oyeniyihakeem08-blip/ECM-Synchronika-Custom-Control-Board/README.md

 Project Description

This specification defines a custom control PCB to replace the factory GICAR control board and PID controller in an ECM Synchronika dual-boiler espresso machine. The design must be:

- **Plug & Play**: Direct replacement using existing machine wiring
- **Reversible**: Original equipment can be reinstalled without modification
- **Universal Voltage**: Support 100-240V AC, 50/60Hz worldwide operation
- **Production Ready**: Suitable for small-batch or volume manufacturing
