oyeniyihakeem08-blip/ECM-Synchronika-Custom-Control-Board/3D MODELS/9 pos terminal block.stp

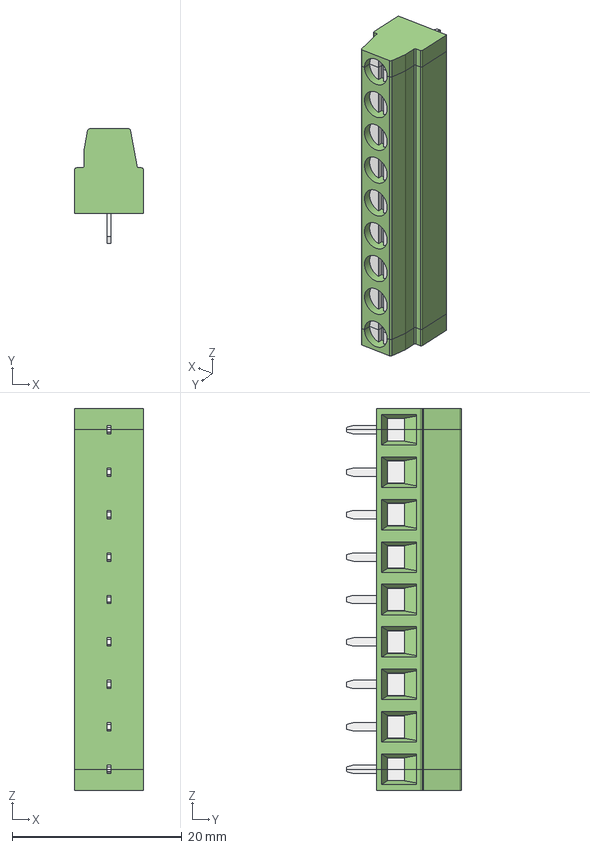
[picture p1: CAD file, 2025-12-05]
3D MODELS/9 pos terminal block.stp
8.10 x 13.5 x 45.0 mm
CIA5_DX
CIA5_SX
CIA5_CNT
