oyeniyihakeem08-blip/ECM-Synchronika-Custom-Control-Board/3D MODELS/7 pos terminal block.stp

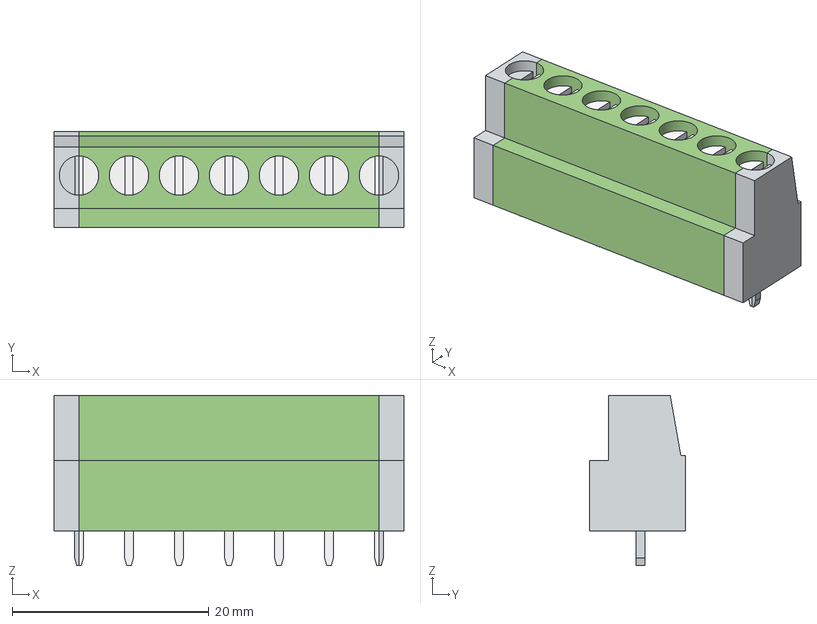
[picture p2: CAD file, 2025-12-05]
3D MODELS/7 pos terminal block.stp
35.6 x 9.80 x 17.3 mm
CLA5_08_SX_PRT.PRT
CLA5_08_DX_PRT.PRT
CLA5_08_CNT_PRT.PRT
