oyeniyihakeem08-blip/ECM-Synchronika-Custom-Control-Board/3D MODELS/5 PIN HEADER HORIZONTAL MTSW-105-24-G-S-155-RA.stp

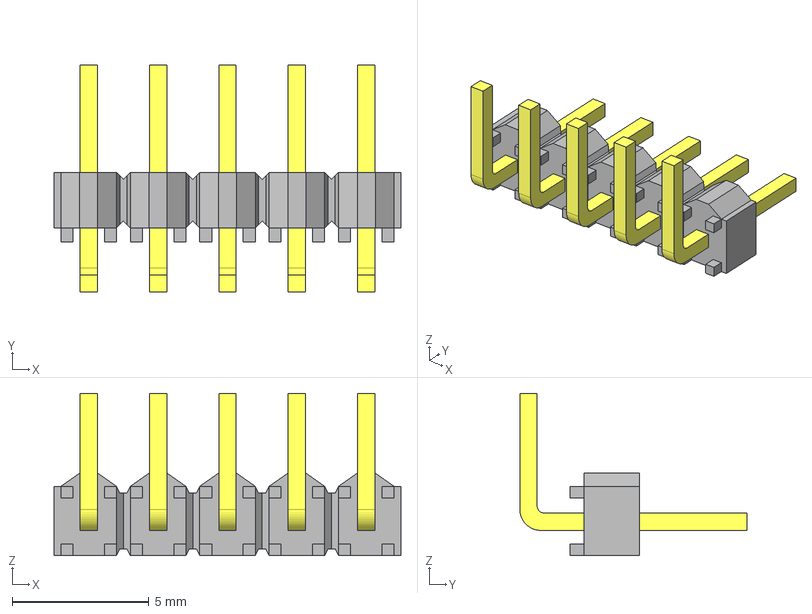
[picture p3: CAD file, 2025-12-03]
3D MODELS/5 PIN HEADER HORIZONTAL MTSW-105-24-G-S-155-RA.stp
12.7 x 8.32 x 5.94 mm
MTSW-105-24-G-S-155-RA_body
MTSW-105-24-S-155-RA
