oyeniyihakeem08-blip/ECM-Synchronika-Custom-Control-Board/3D MODELS/4 PIN HEADER HORIZONTAL MTSW-104-08-G-S-229-RA.stp

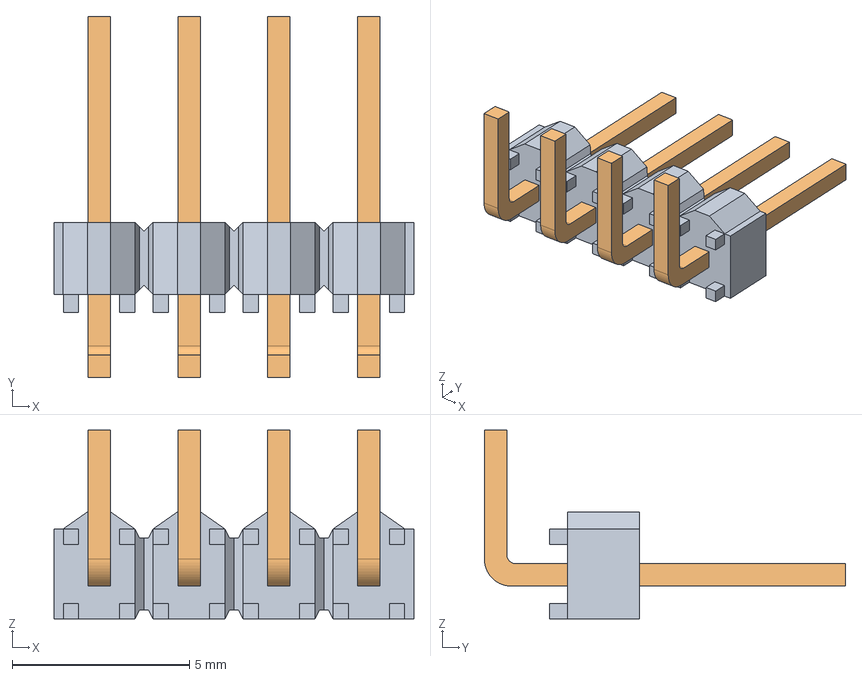
[picture p4: CAD file, 2025-12-03]
3D MODELS/4 PIN HEADER HORIZONTAL MTSW-104-08-G-S-229-RA.stp
10.2 x 10.2 x 5.33 mm
MTSW-104-08-G-S-229-RA_body
MTSW-104-08-S-229-RA
