oyeniyihakeem08-blip/ECM-Synchronika-Custom-Control-Board/3D MODELS/RELAY- G2RL_1.step

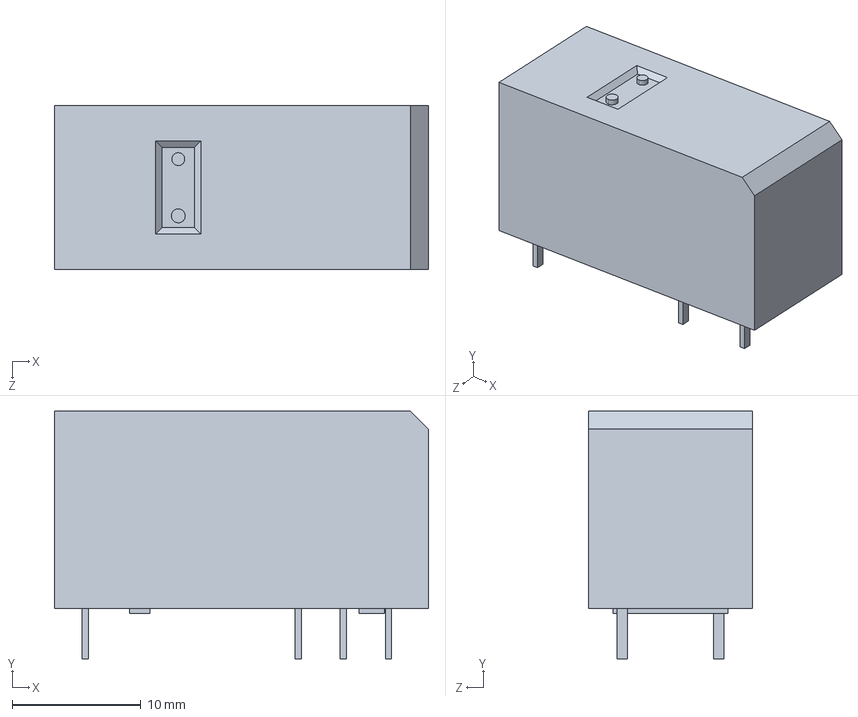
[picture p5: CAD file, 2025-12-02]
3D MODELS/RELAY- G2RL_1.step
29.0 x 19.2 x 12.7 mm
