oyeniyihakeem08-blip/ECM-Synchronika-Custom-Control-Board/3D MODELS/5_pin header  TSW-105-05-L-S-LL.stp

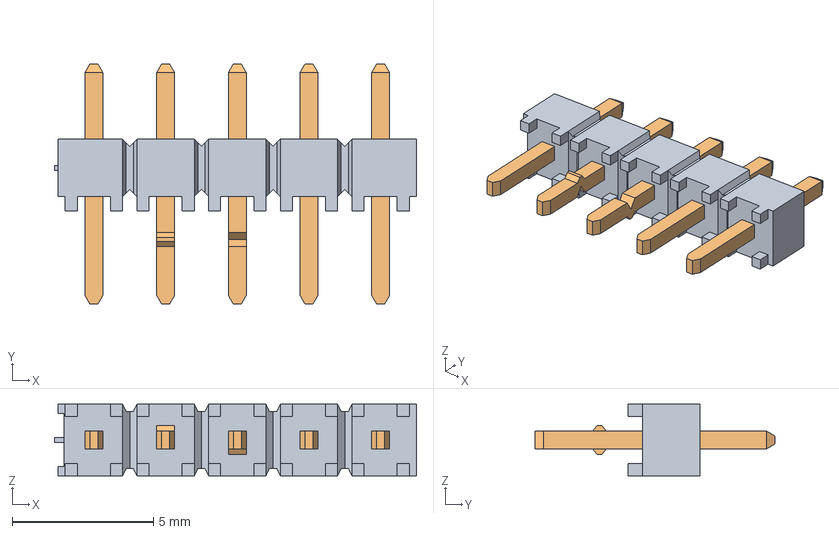
[picture p6: CAD file, 2025-11-30]
3D MODELS/5_pin header TSW-105-05-L-S-LL.stp
12.8 x 8.51 x 2.54 mm
TSW-105-05-L-S-LL_body
T-1S6-21-TSW-1-05-5-S-LL
