oyeniyihakeem08-blip/ECM-Synchronika-Custom-Control-Board/3D MODELS/4-PIN   MTLW-104-06-G-S-135.stp

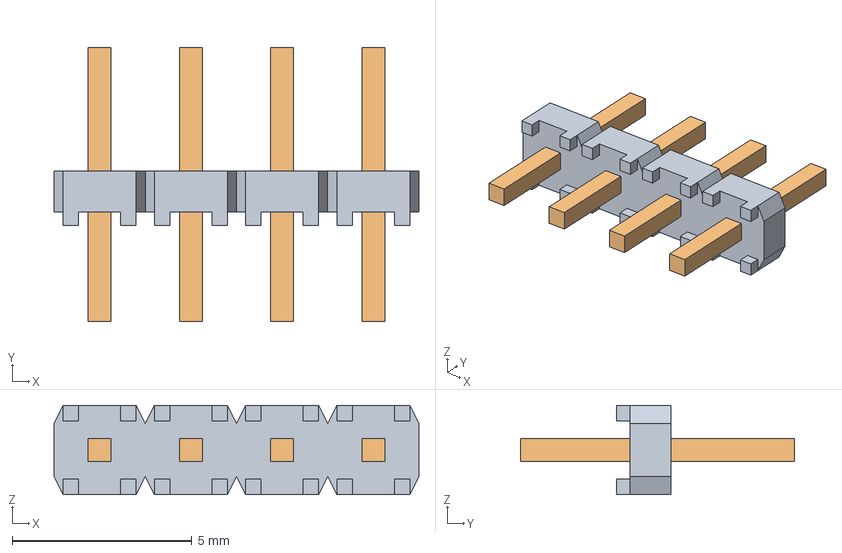
[picture p7: CAD file, 2025-11-30]
3D MODELS/4-PIN MTLW-104-06-G-S-135.stp
10.2 x 7.62 x 2.49 mm
MTLW-104-06-G-S-135_body
MTLW-04-06-S-135
