oyeniyihakeem08-blip/ECM-Synchronika-Custom-Control-Board/3D MODELS/COMPARATOR-TLV3201AIDBVR.step

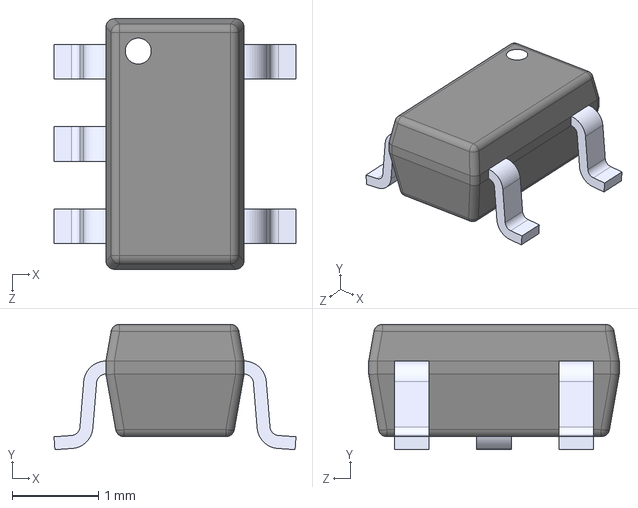
[picture p8: CAD file, 2025-11-30]
3D MODELS/COMPARATOR-TLV3201AIDBVR.step
2.80 x 1.45 x 2.90 mm
