oyeniyihakeem08-blip/ECM-Synchronika-Custom-Control-Board/3D MODELS/8_PIN_  BM08B-GHS-TBT_LF__SN__N_.step

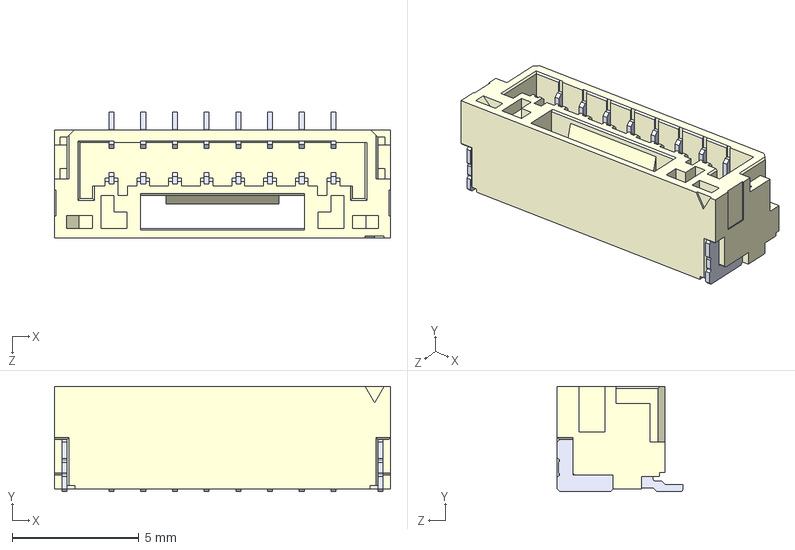
[picture p9: CAD file, 2025-11-30]
3D MODELS/8_PIN_ BM08B-GHS-TBT_LF__SN__N_.step
13.2 x 4.15 x 4.95 mm
