oyeniyihakeem08-blip/ECM-Synchronika-Custom-Control-Board/3D MODELS/6.3mm spade   928814-1.step

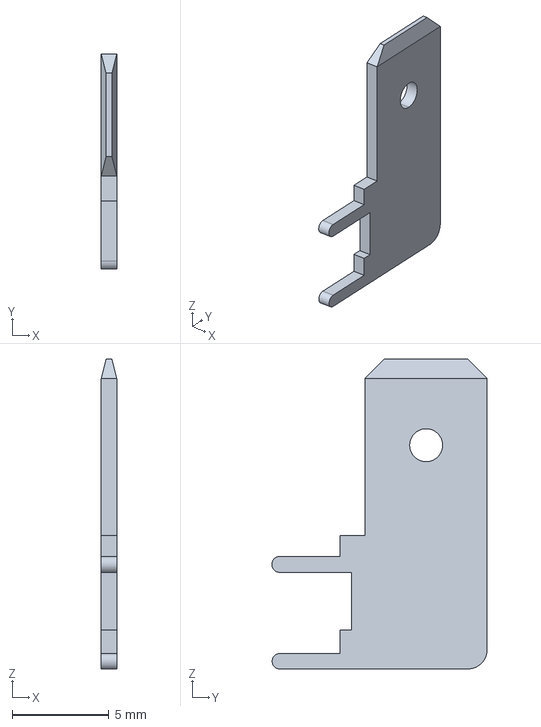
[picture p10: CAD file, 2025-11-29]
3D MODELS/6.3mm spade 928814-1.step
0.8 x 11.1 x 16.0 mm
