oyeniyihakeem08-blip/ECM-Synchronika-Custom-Control-Board/3D MODELS/HLK-5M05.step

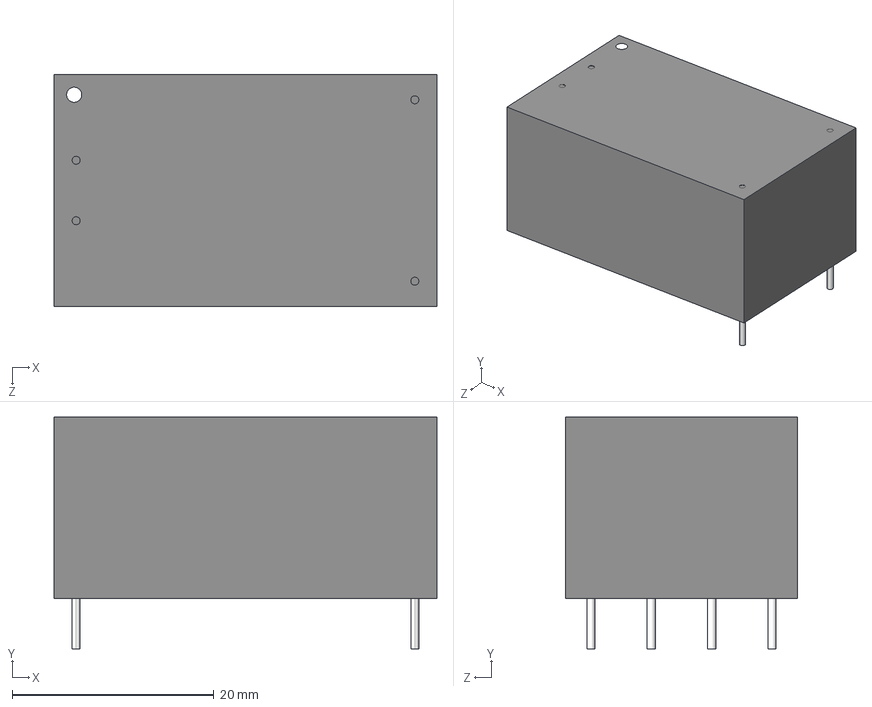
[picture p11: CAD file, 2025-11-29]
3D MODELS/HLK-5M05.step
38.0 x 23.0 x 23.0 mm
