oyeniyihakeem08-blip/ECM-Synchronika-Custom-Control-Board/3D MODELS/SMD SWITCH  EVQ-P7A01P.step

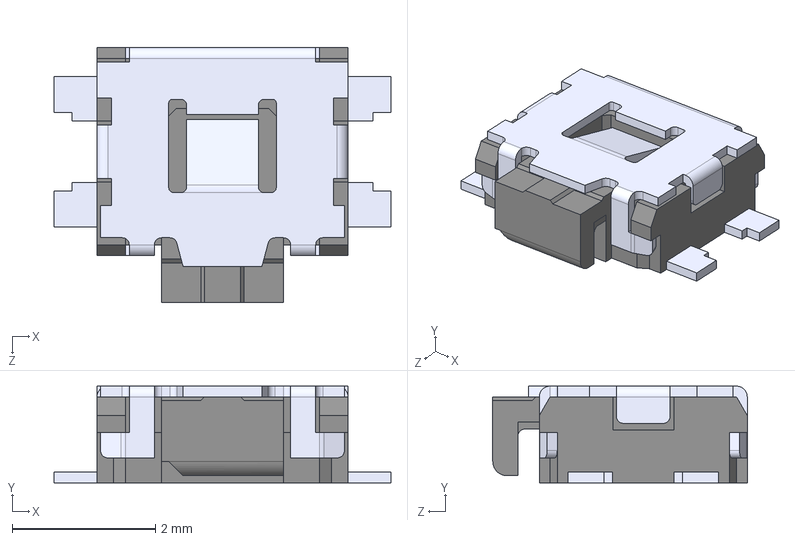
[picture p12: CAD file, 2025-11-29]
3D MODELS/SMD SWITCH EVQ-P7A01P.step
4.70 x 1.35 x 3.55 mm
