oyeniyihakeem08-blip/ECM-Synchronika-Custom-Control-Board/3D MODELS/PICO SC0915.step

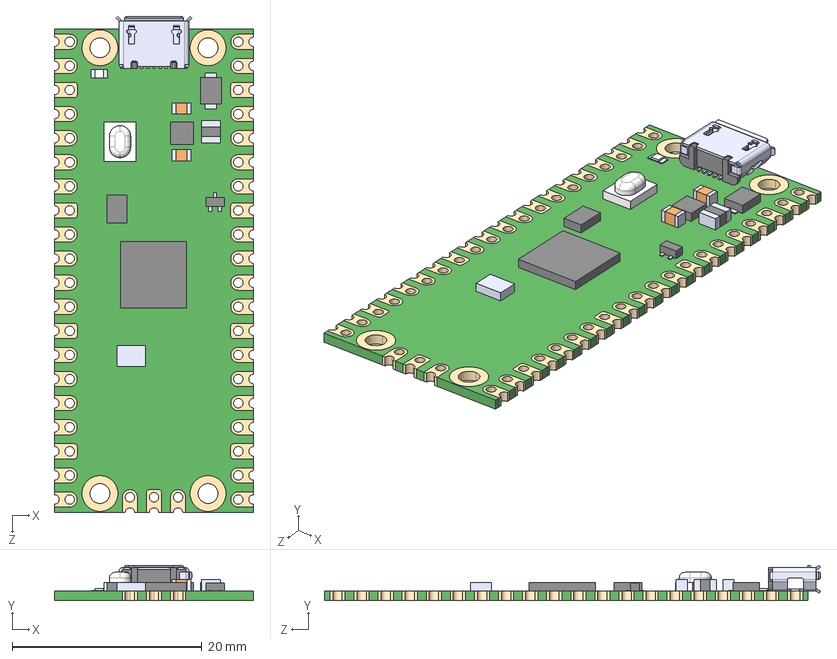
[picture p13: CAD file, 2025-11-29]
3D MODELS/PICO SC0915.step
21.0 x 3.73 x 52.3 mm
