oyeniyihakeem08-blip/ECM-Synchronika-Custom-Control-Board/3D MODELS/SPDT  40.61.9.012.0000.stp

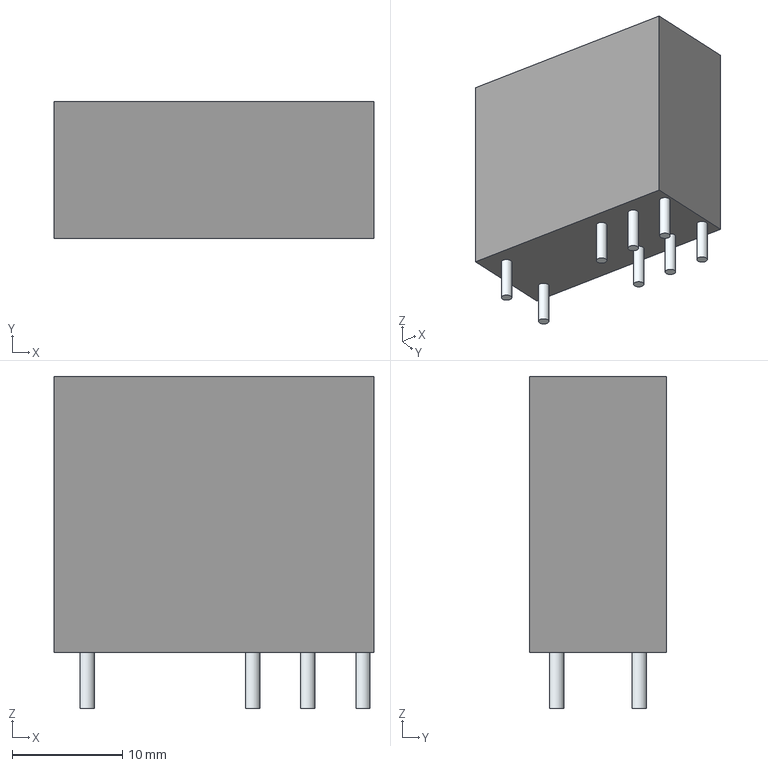
[picture p14: CAD file, 2025-11-29]
3D MODELS/SPDT 40.61.9.012.0000.stp
29.0 x 12.4 x 30.1 mm
Leads x 8
