oyeniyihakeem08-blip/ECM-Synchronika-Custom-Control-Board/ECM Synchronika Custom Control Board.kicad_pcb

## KiCad design ECM Synchronika Custom Control Board.kicad_pcb (2025-12-05)

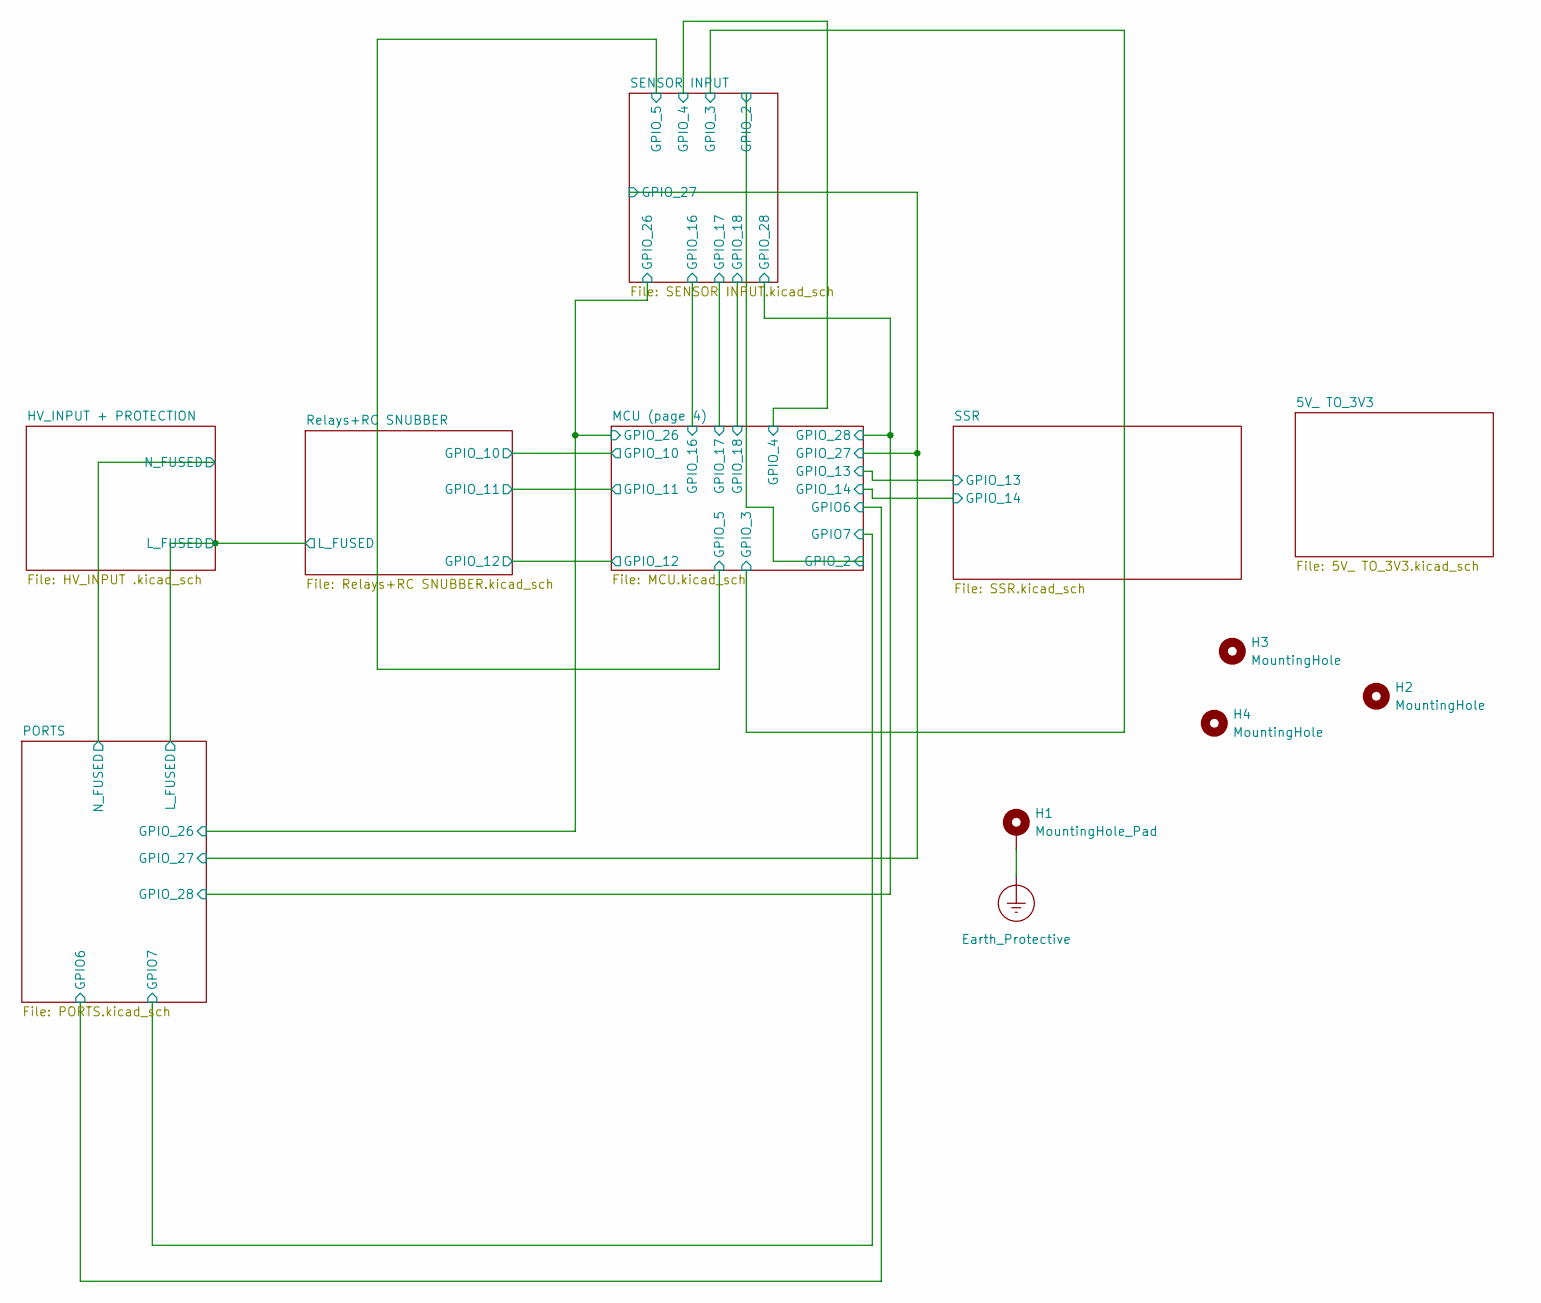
[picture p15: schematic ECM Synchronika Custom Control Board.kicad_sch]

Parts:
H1: MountingHole_Pad; MountingHole_3.2mm_M3_ISO7380_Pad_TopBottom
H2, H3, H4: MountingHole; MountingHole_3.2mm_M3_ISO14580

Connections:
Earth_Protective: H1.1; also elsewhere on the board

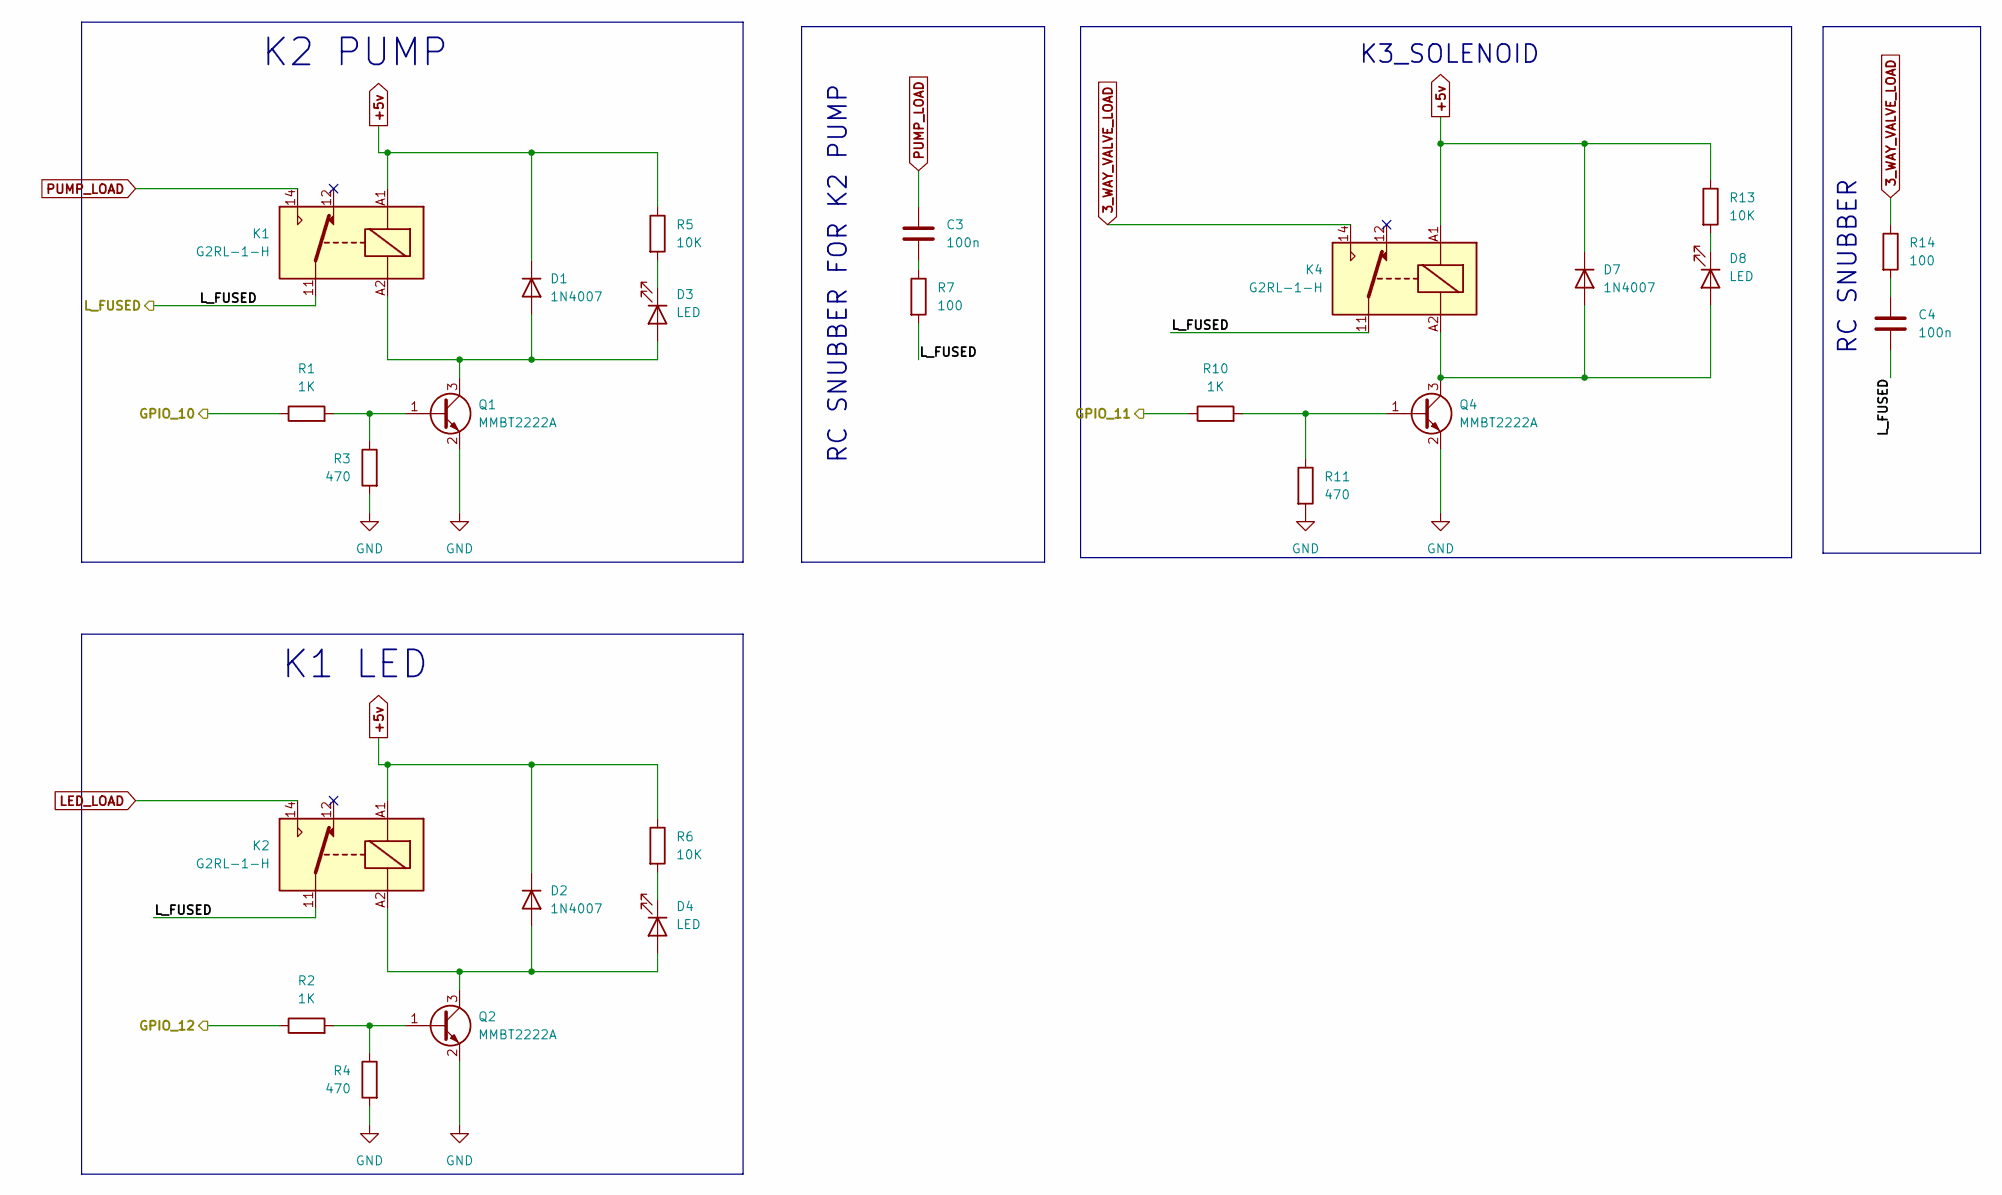
[picture p16: schematic Relays+RC SNUBBER.kicad_sch]

Parts:
C3, C4: 100n; C_Rect_L26.5mm_W11.5mm_P22.50mm_MKS4
D1, D2, D7: 1N4007; D_SMA
D3, D4, D8: LED; LED_0805_2012Metric
K1, K2, K4: G2RL-1-H; Relay_SPDT_Omron_G2RL-1 MODIFIED
Q1, Q2, Q4: MMBT2222A; SOT-23
R1, R2, R10: 1K; R_0805_2012Metric
R3, R4, R11: 470; R_0805_2012Metric
R5, R6, R13: 10K; R_0805_2012Metric
R7, R14: 100; R_1210_3225Metric

Connections:
3_WAY_VALVE_LOAD: K4.14, R14.1; also elsewhere on the board
+5v: D1.1 (K), D2.1 (K), D7.1 (K), K1.A1, K2.A1, K4.A1, R5.1, R6.1, R13.1; also elsewhere on the board
/HV_INPUT + PROTECTION/L_FUSED: C4.2, K1.11, K2.11, K4.11, R7.2; also elsewhere on the board
/MCU (page 4)/GPIO_10: R1.1; also elsewhere on the board
/MCU (page 4)/GPIO_11: R10.1; also elsewhere on the board
/MCU (page 4)/GPIO_12: R2.1; also elsewhere on the board
GND: Q1.2 (E), Q2.2 (E), Q4.2 (E), R3.2, R4.2, R11.2; also elsewhere on the board
LED_LOAD: K2.14; also elsewhere on the board
unnamed: C3.2, R7.1
unnamed: C4.1, R14.2
unnamed: D1.2 (A), D3.2 (A), K1.A2, Q1.3 (C)
unnamed: D2.2 (A), D4.2 (A), K2.A2, Q2.3 (C)
unnamed: D3.1 (K), R5.2
unnamed: D4.1 (K), R6.2
unnamed: D7.2 (A), D8.2 (A), K4.A2, Q4.3 (C)
unnamed: D8.1 (K), R13.2
unnamed: Q1.1 (B), R1.2, R3.1
unnamed: Q2.1 (B), R2.2, R4.1
unnamed: Q4.1 (B), R10.2, R11.1
PUMP_LOAD: C3.1, K1.14; also elsewhere on the board

Notes on the sheet:
K1 LED
RC SNUBBER
K2 PUMP
RC SNUBBER FOR K2 PUMP
K3_SOLENOID

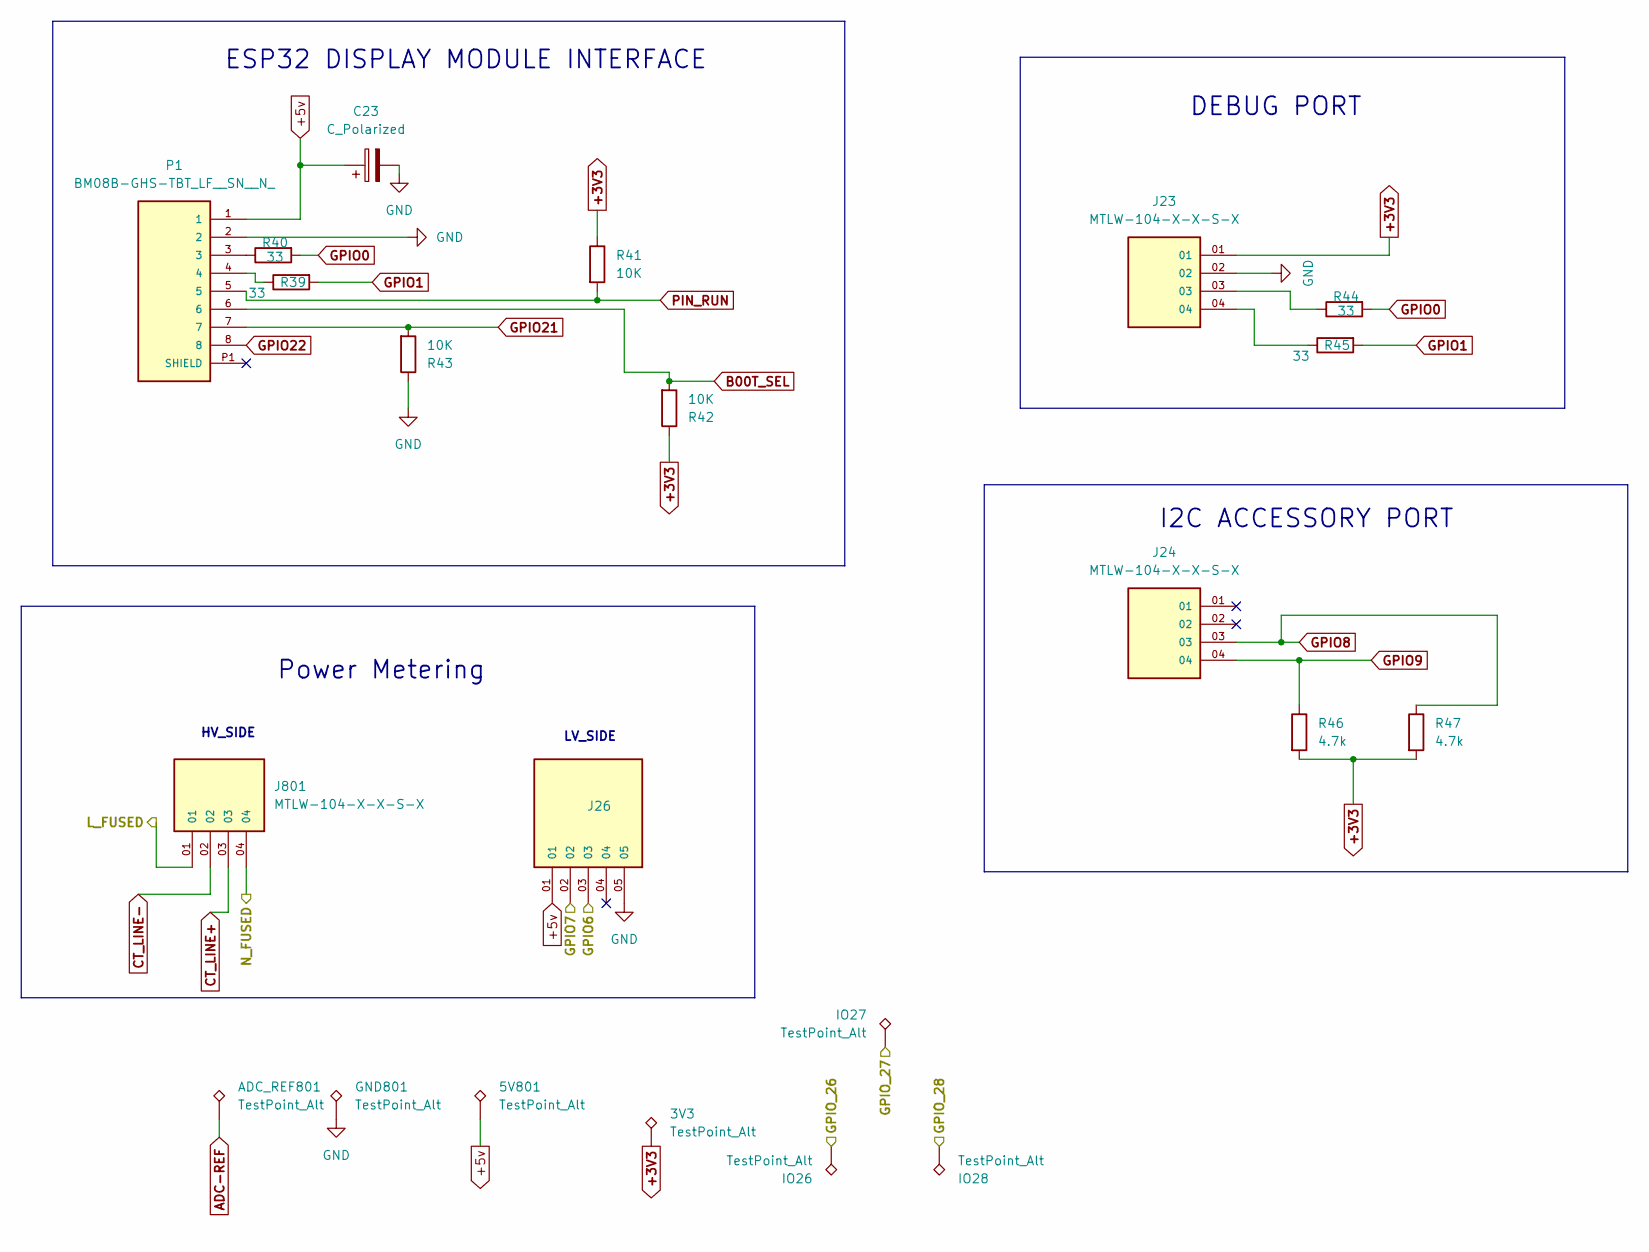
[picture p17: schematic PORTS.kicad_sch]

Parts:
3V3, 5V801: TestPoint_Alt; Pin_D1.0mm_L10.0mm_LooseFit
ADC_REF801: TestPoint_Alt; Pin_D1.0mm_L10.0mm_LooseFit
C23: C_Polarized; CP_Elec_5x5.4
GND801: TestPoint_Alt; Pin_D1.0mm_L10.0mm_LooseFit
IO26, IO27, IO28: TestPoint_Alt; Pin_D1.0mm_L10.0mm_LooseFit
J23, J24, J801: MTLW-104-X-X-S-X; SAMTEC_MTLW-104-X-X-S-X; PARTREV A
J26: TSW-105-05-L-S-LL; SAMTEC_TSW-105-05-L-S-LL; PARTREV R
P1: BM08B-GHS-TBT_LF__SN__N_; JST_BM08B-GHS-TBT_LF__SN__N_
R39, R40, R44, R45: 33; R_0805_2012Metric
R41, R42, R43: 10K; R_0603_1608Metric
R46, R47: 4.7k; R_0603_1608Metric

Connections:
+3V3: 3V3.1, J23.01, R41.1, R42.1, R46.2, R47.2; also elsewhere on the board
+5v: 5V801.1, C23.1, J26.01, P1.1; also elsewhere on the board
/HV_INPUT + PROTECTION/L_FUSED: J801.01; also elsewhere on the board
/HV_INPUT + PROTECTION/N_FUSED: J801.04; also elsewhere on the board
/MCU (page 4)/GPIO6: J26.03; also elsewhere on the board
/MCU (page 4)/GPIO7: J26.02; also elsewhere on the board
/MCU (page 4)/GPIO_26: IO26.1; also elsewhere on the board
/MCU (page 4)/GPIO_27: IO27.1; also elsewhere on the board
/SENSOR INPUT/GPIO_28: IO28.1; also elsewhere on the board
ADC-REF: ADC_REF801.1; also elsewhere on the board
B00T_SEL: P1.6, R42.2; also elsewhere on the board
CT_LINE+: J801.03; also elsewhere on the board
CT_LINE-: J801.02; also elsewhere on the board
GND: C23.2, GND801.1, J23.02, J26.05, P1.2, R43.1; also elsewhere on the board
GPIO0: R40.2, R44.2; also elsewhere on the board
GPIO1: R39.2, R45.2; also elsewhere on the board
GPIO8: J24.03, R47.1; also elsewhere on the board
GPIO9: J24.04, R46.1; also elsewhere on the board
GPIO21: P1.7, R43.2; also elsewhere on the board
GPIO22: P1.8; also elsewhere on the board
unnamed: J23.03, R44.1
unnamed: J23.04, R45.1
unnamed: P1.3, R40.1
unnamed: P1.4, R39.1
PIN_RUN: P1.5, R41.2; also elsewhere on the board

Notes on the sheet:
DEBUG PORT
ESP32 DISPLAY MODULE INTERFACE
I2C ACCESSORY PORT
HV_SIDE
LV_SIDE
Power Metering

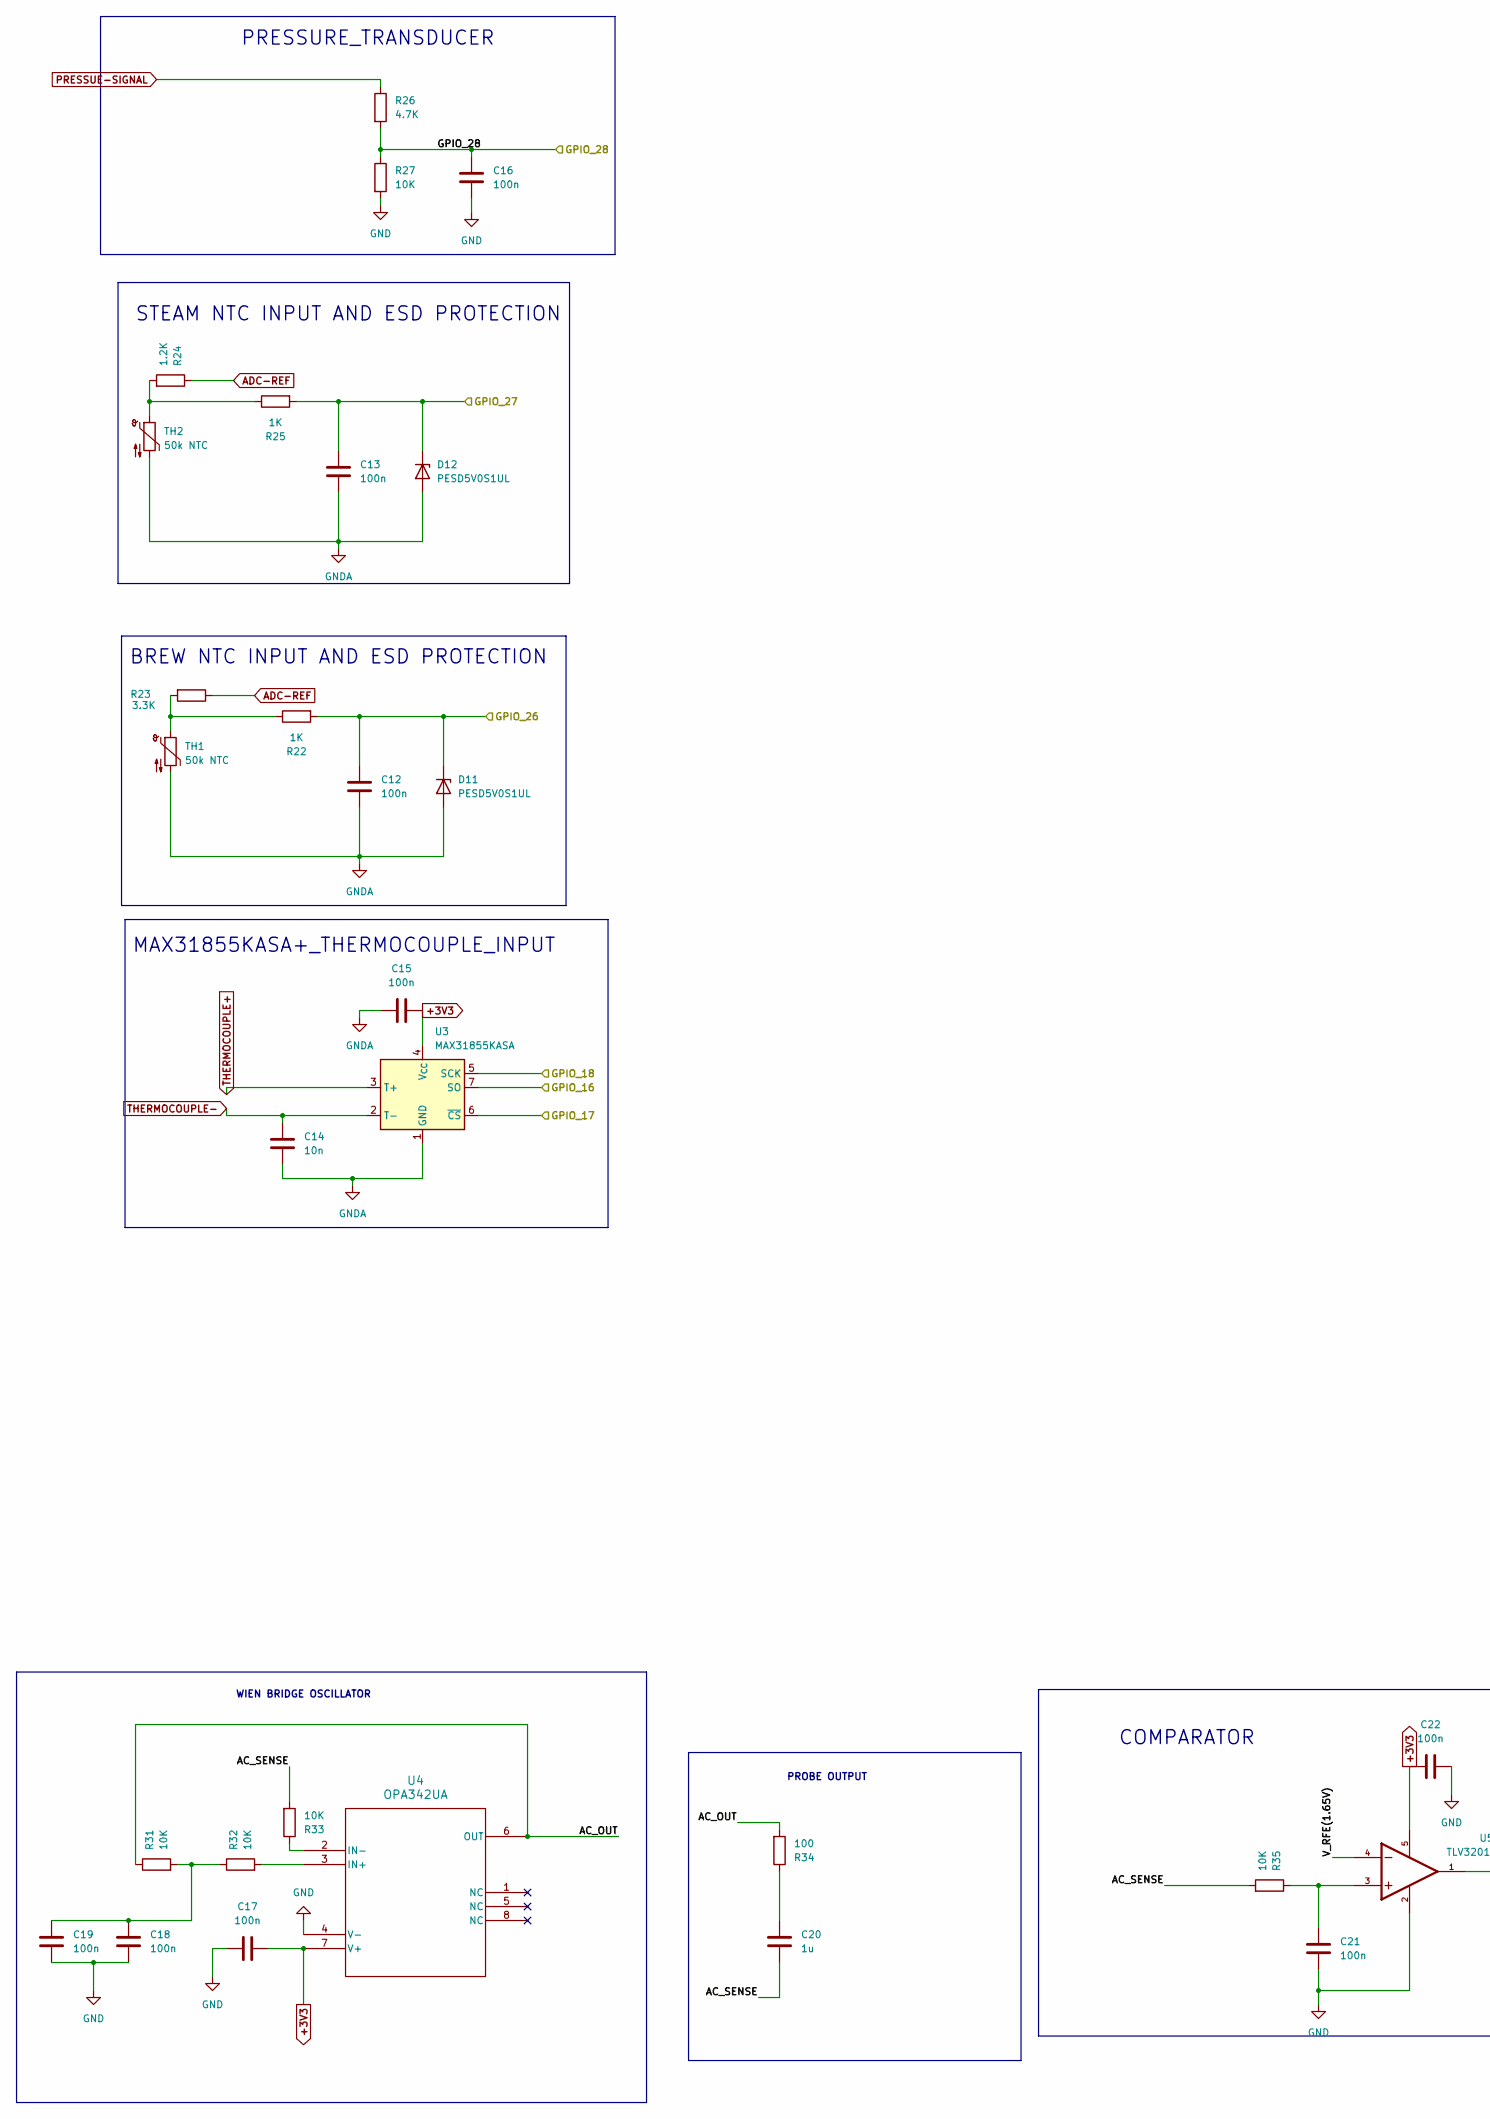
[picture p18: schematic SENSOR INPUT.kicad_sch, part in row 1, column 1]

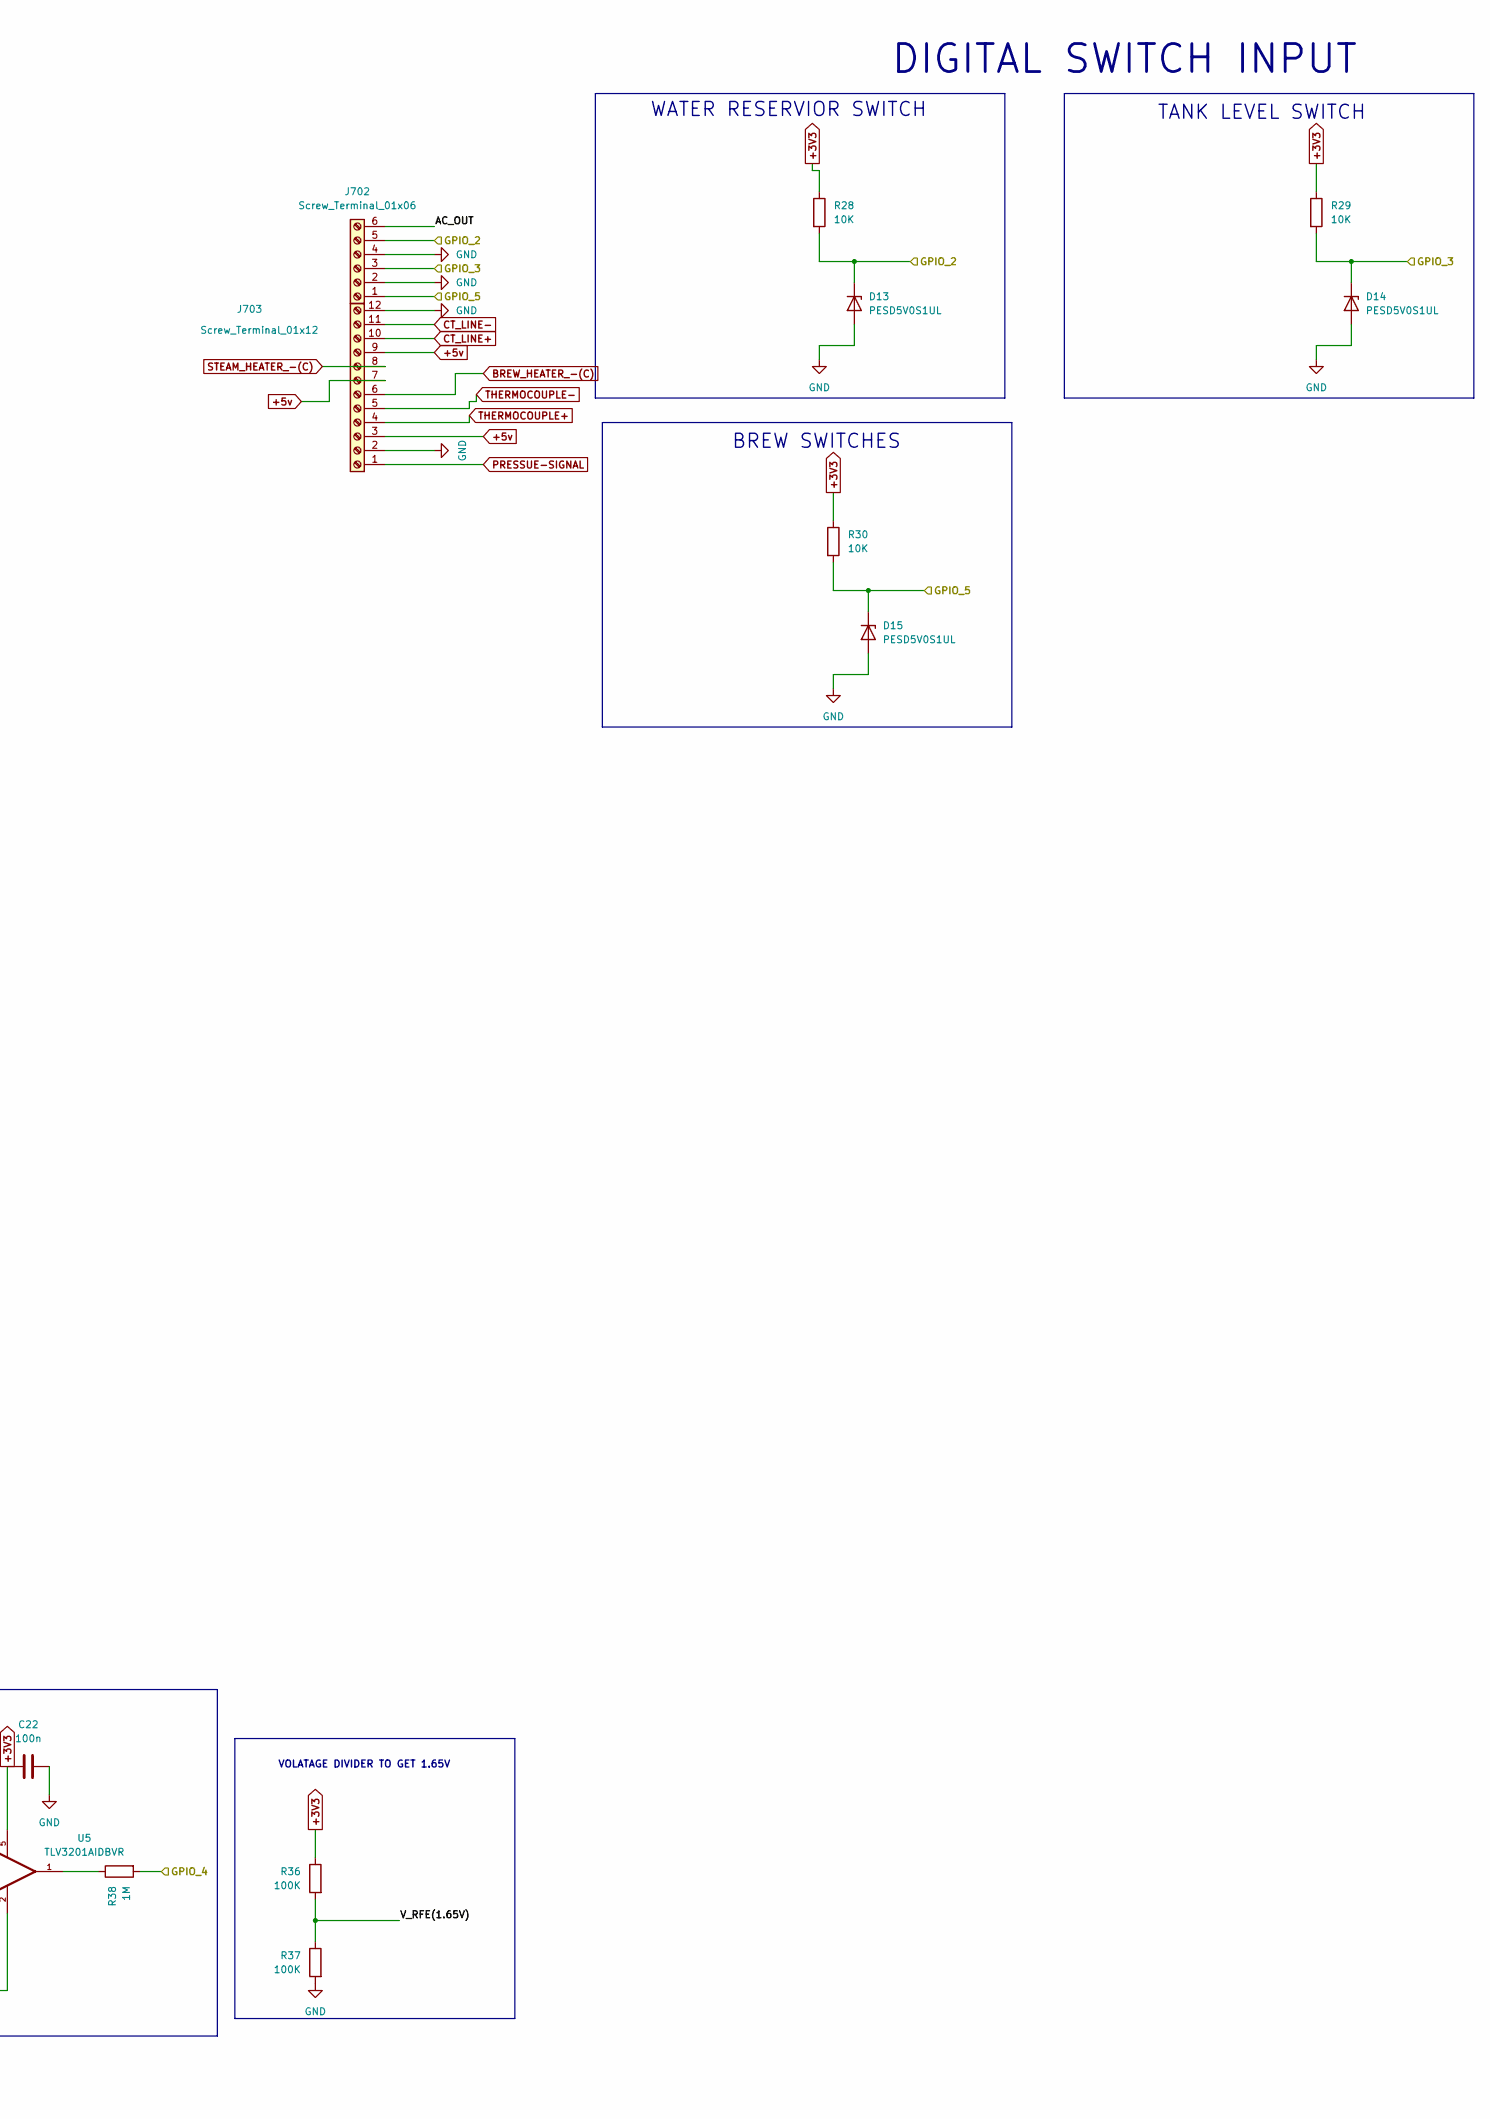
[picture p19: schematic SENSOR INPUT.kicad_sch, part in row 1, column 2]

Parts:
C12, C13, C15, C16: 100n; C_0805_2012Metric
C14: 10n; C_0805_2012Metric
C17, C18, C19, C21, C22: 100n; C_0603_1608Metric
C20: 1u; C_0603_1608Metric
D11, D12, D13, D14, D15: PESD5V0S1UL; D_SOD-882
J702: Screw_Terminal_01x06; TerminalBlock_Phoenix_MPT-0,5-6-2.54_1x06_P2.54mm_Horizontal
J703: Screw_Terminal_01x12; TerminalBlock_Phoenix_MPT-0,5-12-2.54_1x12_P2.54mm_Horizont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
R22, R25: 1K; R_0805_2012Metric
R23: 3.3K; R_0805_2012Metric
R24: 1.2K; R_0805_2012Metric
R26: 4.7K; R_0805_2012Metric
R27, R28, R29, R30, R31, R32, R33, R35: 10K; R_0805_2012Metric
R34: 100; R_0805_2012Metric
R36, R37: 100K; R_0805_2012Metric
R38: 1M; R_0805_2012Metric
TH1, TH2: 50k NTC; R_0603_1608Metric
U3: MAX31855KASA; SOIC-8_3.9x4.9mm_P1.27mm
U4: OPA342UA; D8
U5: TLV3201AIDBVR; COMPARTOR_SOT95P280X145-5N; PARTREV B

Connections:
+3V3: C15.2, C17.2, C22.2, R28.1, R29.1, R30.1, R36.1, U3.4 (V_{CC}), U4.7 (V+), U5.5; also elsewhere on the board
+5v: J703.3, J703.7, J703.9; also elsewhere on the board
/MCU (page 4)/GPIO_2: D13.1 (K), J702.5, R28.2; also elsewhere on the board
/MCU (page 4)/GPIO_3: D14.1 (K), J702.3, R29.2; also elsewhere on the board
/MCU (page 4)/GPIO_4: R38.2; also elsewhere on the board
/MCU (page 4)/GPIO_5: D15.1 (K), J702.1, R30.2; also elsewhere on the board
/MCU (page 4)/GPIO_16: U3.7 (SO); also elsewhere on the board
/MCU (page 4)/GPIO_17: U3.6 (~CS); also elsewhere on the board
/MCU (page 4)/GPIO_18: U3.5 (SCK); also elsewhere on the board
/MCU (page 4)/GPIO_26: C12.1, D11.1 (K), R22.2; also elsewhere on the board
/MCU (page 4)/GPIO_27: C13.1, D12.1 (K), R25.2; also elsewhere on the board
/SENSOR INPUT/AC_OUT: J702.6, R31.1, R34.2, U4.6 (OUT)
/SENSOR INPUT/AC_SENSE: C20.1, R33.2, R35.2
/SENSOR INPUT/GPIO_28: C16.1, R26.2, R27.1; also elsewhere on the board
/SENSOR INPUT/V_RFE(1.65V): R36.2, R37.1, U5.4
ADC-REF: R23.1, R24.1; also elsewhere on the board
BREW_HEATER_-(C): J703.6; also elsewhere on the board
CT_LINE+: J703.10; also elsewhere on the board
CT_LINE-: J703.11; also elsewhere on the board
GND: C16.2, C17.1, C18.1, C19.1, C21.1, C22.1, D13.2 (A), D14.2 (A), D15.2 (A), J702.2, J702.4, J703.2, J703.12, R27.2, R37.2, U4.4 (V-), U5.2; also elsewhere on the board
GNDA: C12.2, C13.2, C14.2, C15.1, D11.2 (A), D12.2 (A), TH1.2, TH2.2, U3.1 (GND); also elsewhere on the board
unnamed: C18.2, C19.2, R31.2, R32.1
unnamed: C20.2, R34.1
unnamed: C21.2, R35.1, U5.3
unnamed: R22.1, R23.2, TH1.1
unnamed: R24.2, R25.1, TH2.1
unnamed: R38.1, U5.1
unnamed: R32.2, U4.3 (IN+)
unnamed: R33.1, U4.2 (IN-)
PRESSUE-SIGNAL: J703.1, R26.1
STEAM_HEATER_-(C): J703.8; also elsewhere on the board
THERMOCOUPLE+: J703.4, U3.3 (T+)
THERMOCOUPLE-: C14.1, J703.5, U3.2 (T-)

Notes on the sheet:
PROBE OUTPUT
DIGITAL SWITCH INPUT
WIEN BRIDGE OSCILLATOR
BREW NTC INPUT AND ESD PROTECTION
WATER RESERVIOR SWITCH
MAX31855KASA+_THERMOCOUPLE_INPUT
VOLATAGE DIVIDER TO GET 1.65V
COMPARATOR
STEAM NTC INPUT AND ESD PROTECTION
TANK LEVEL SWITCH
BREW SWITCHES
PRESSURE_TRANSDUCER

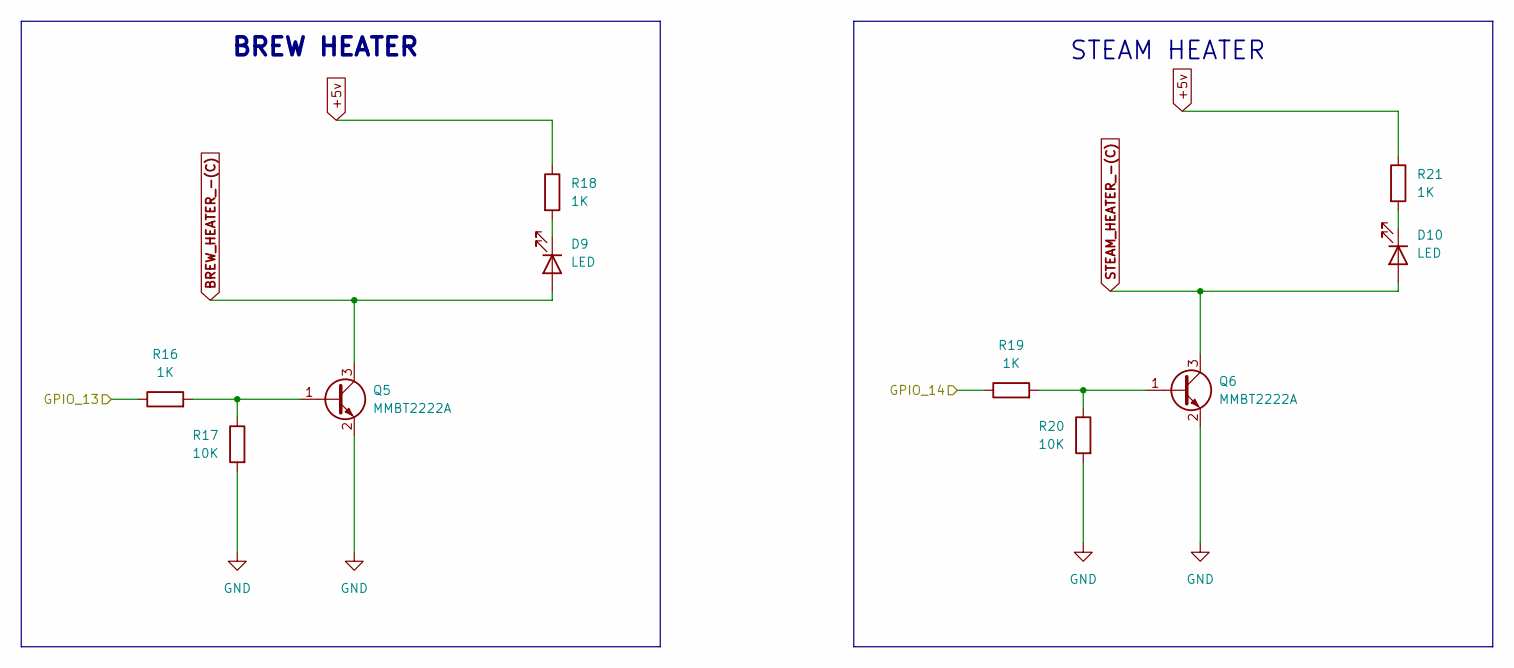
[picture p20: schematic SSR.kicad_sch]

Parts:
D9, D10: LED; LED_0805_2012Metric
Q5, Q6: MMBT2222A; SOT-23
R16, R18, R19, R21: 1K; R_0805_2012Metric
R17, R20: 10K; R_0805_2012Metric

Connections:
+5v: R18.1, R21.1; also elsewhere on the board
/MCU (page 4)/GPIO_13: R16.1; also elsewhere on the board
/MCU (page 4)/GPIO_14: R19.1; also elsewhere on the board
BREW_HEATER_-(C): D9.2 (A), Q5.3 (C); also elsewhere on the board
GND: Q5.2 (E), Q6.2 (E), R17.2, R20.2; also elsewhere on the board
unnamed: D9.1 (K), R18.2
unnamed: D10.1 (K), R21.2
unnamed: Q5.1 (B), R16.2, R17.1
unnamed: Q6.1 (B), R19.2, R20.1
STEAM_HEATER_-(C): D10.2 (A), Q6.3 (C); also elsewhere on the board

Notes on the sheet:
STEAM HEATER
BREW HEATER

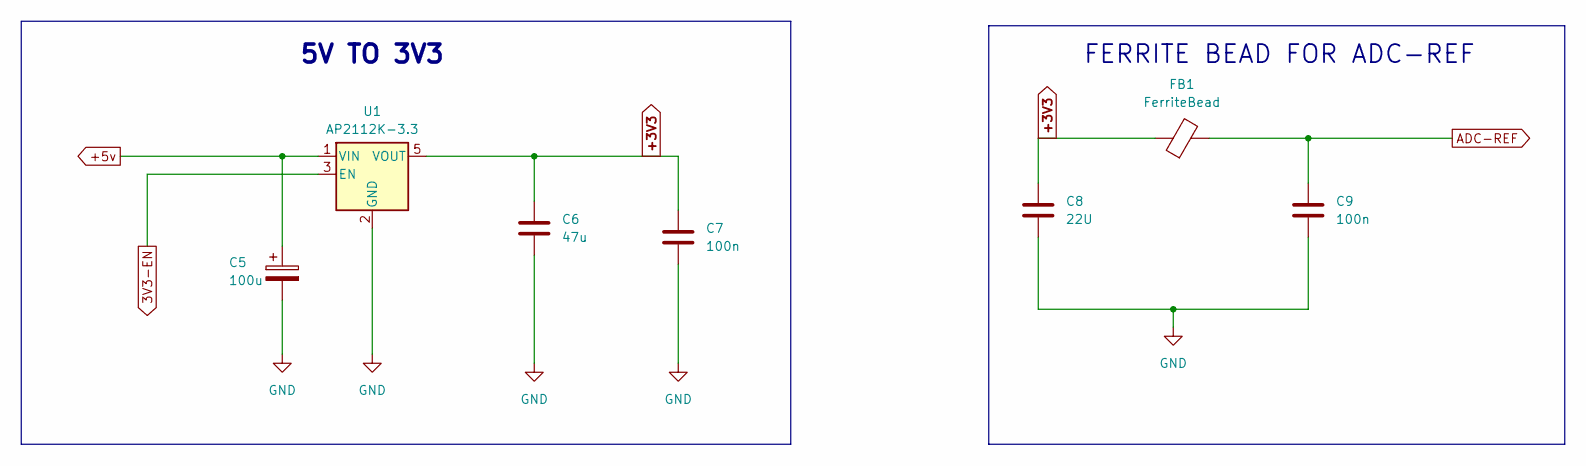
[picture p21: schematic 5V_ TO_3V3.kicad_sch]

Parts:
C5: 100u; CP_Elec_6.3x5.9
C6: 47u; C_1206_3216Metric; voltage 10v
C7, C9: 100n; C_0805_2012Metric
C8: 22U; C_1206_3216Metric
FB1: FerriteBead; L_0603_1608Metric
U1: AP2112K-3.3; SOT-23-5

Connections:
3V3-EN: U1.3 (EN); also elsewhere on the board
+3V3: C6.1, C7.1, C8.1, FB1.1, U1.5 (VOUT); also elsewhere on the board
+5v: C5.1, U1.1 (VIN); also elsewhere on the board
ADC-REF: C9.1, FB1.2; also elsewhere on the board
GND: C5.2, C6.2, C7.2, C8.2, C9.2, U1.2 (GND); also elsewhere on the board

Notes on the sheet:
FERRITE BEAD FOR ADC-REF
5V TO 3V3

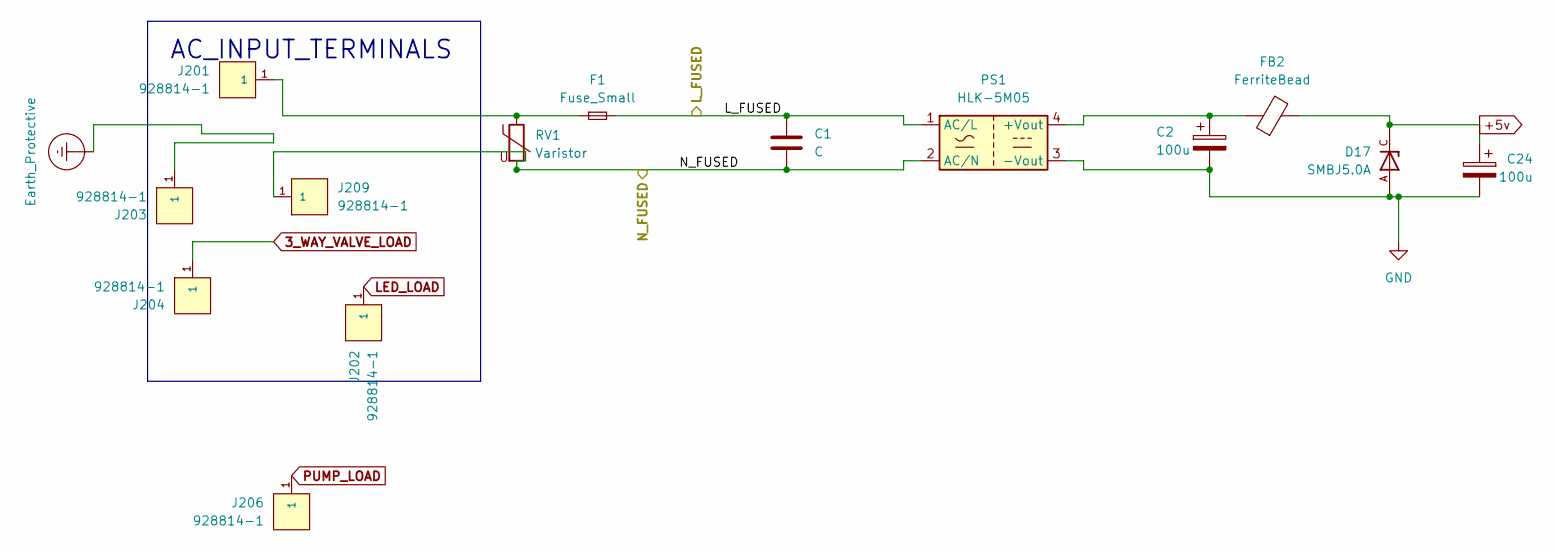
[picture p22: schematic HV_INPUT .kicad_sch]

Parts:
C1: C; C_Rect_L18.0mm_W5.0mm_P15.00mm_FKS3_FKP3
C2, C24: 100u; CP_Elec_6.3x5.9
D17: SMBJ5.0A; DIOM4336X265N; PARTREV F2102
F1: Fuse_Small; Fuseholder_Clip-5x20mm_Littelfuse_111_Inline_P20.00x5.00mm_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
FB2: FerriteBead; L_0603_1608Metric
J201, J202, J203, J204, J206, J209: 928814-1; TE_928814-1; PARTREV 3-11
PS1: HLK-5M05; Converter_ACDC_Hi-Link_HLK-5Mxx
RV1: Varistor; RV_Disc_D15.5mm_W4.9mm_P7.5mm

Connections:
3_WAY_VALVE_LOAD: J204.1; also elsewhere on the board
+5v: C24.1, D17.C, FB2.2; also elsewhere on the board
/HV_INPUT + PROTECTION/L_FUSED: C1.1, F1.2, PS1.1 (AC/L); also elsewhere on the board
/HV_INPUT + PROTECTION/N_FUSED: C1.2, J209.1, PS1.2 (AC/N), RV1.2; also elsewhere on the board
Earth_Protective: J203.1; also elsewhere on the board
GND: C2.2, C24.2, D17.A, PS1.3 (-Vout); also elsewhere on the board
LED_LOAD: J202.1; also elsewhere on the board
unnamed: F1.1, J201.1, RV1.1
unnamed: C2.1, FB2.1, PS1.4 (+Vout)
PUMP_LOAD: J206.1; also elsewhere on the board

Notes on the sheet:
AC_INPUT_TERMINALS
