oyeniyihakeem08-blip/ECM-Synchronika-Custom-Control-Board/ECM Synchronika Custom Control Board.kicad_pcb

## KiCad design ECM Synchronika Custom Control Board.kicad_pcb (continued)

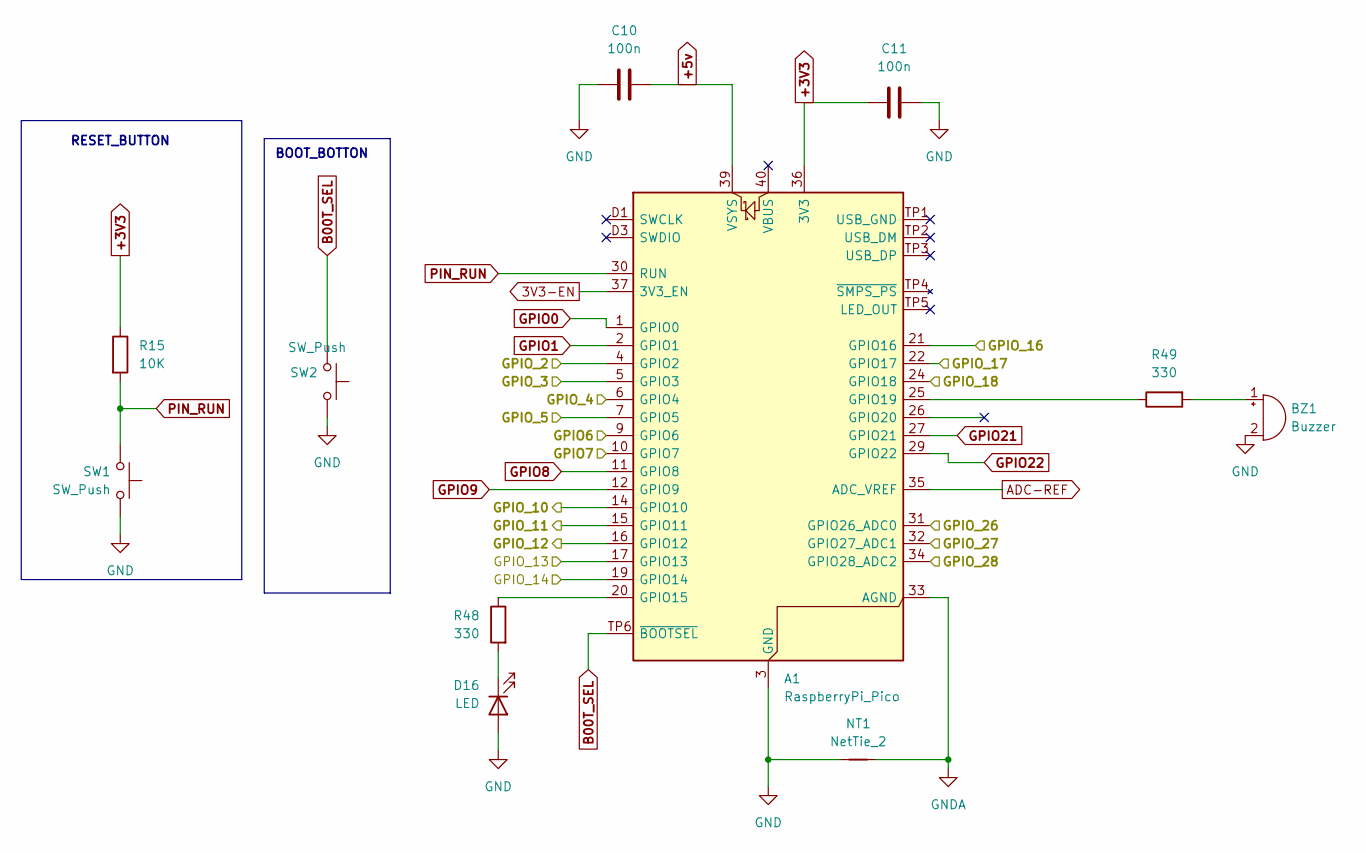
[picture p23: schematic MCU.kicad_sch]

Parts:
A1: RaspberryPi_Pico; RaspberryPi_Pico_SMD
BZ1: Buzzer; Buzzer_12x9.5RM7.6
C10, C11: 100n; C_0603_1608Metric
D16: LED; LED_0805_2012Metric
NT1: NetTie_2; NetTie-2_SMD_Pad2.0mm
R15: 10K; R_0603_1608Metric
R48, R49: 330; R_0805_2012Metric
SW1, SW2: SW_Push; SW_PUSH_6mm

Connections:
3V3-EN: A1.37 (3V3_EN); also elsewhere on the board
+3V3: A1.36 (3V3), C11.1, R15.1; also elsewhere on the board
+5v: A1.39 (VSYS), C10.2; also elsewhere on the board
/MCU (page 4)/GPIO6: A1.9 (GPIO6); also elsewhere on the board
/MCU (page 4)/GPIO7: A1.10 (GPIO7); also elsewhere on the board
/MCU (page 4)/GPIO_2: A1.4 (GPIO2); also elsewhere on the board
/MCU (page 4)/GPIO_3: A1.5 (GPIO3); also elsewhere on the board
/MCU (page 4)/GPIO_4: A1.6 (GPIO4); also elsewhere on the board
/MCU (page 4)/GPIO_5: A1.7 (GPIO5); also elsewhere on the board
/MCU (page 4)/GPIO_10: A1.14 (GPIO10); also elsewhere on the board
/MCU (page 4)/GPIO_11: A1.15 (GPIO11); also elsewhere on the board
/MCU (page 4)/GPIO_12: A1.16 (GPIO12); also elsewhere on the board
/MCU (page 4)/GPIO_13: A1.17 (GPIO13); also elsewhere on the board
/MCU (page 4)/GPIO_14: A1.19 (GPIO14); also elsewhere on the board
/MCU (page 4)/GPIO_16: A1.21 (GPIO16); also elsewhere on the board
/MCU (page 4)/GPIO_17: A1.22 (GPIO17); also elsewhere on the board
/MCU (page 4)/GPIO_18: A1.24 (GPIO18); also elsewhere on the board
/MCU (page 4)/GPIO_26: A1.31 (GPIO26_ADC0); also elsewhere on the board
/MCU (page 4)/GPIO_27: A1.32 (GPIO27_ADC1); also elsewhere on the board
/SENSOR INPUT/GPIO_28: A1.34 (GPIO28_ADC2); also elsewhere on the board
ADC-REF: A1.35 (ADC_VREF); also elsewhere on the board
B00T_SEL: A1.TP6 (~BOOTSEL), SW2.2; also elsewhere on the board
GND: A1.3 (GND), A1.8 (GND), A1.13 (GND), A1.18 (GND), A1.23 (GND), A1.28 (GND), A1.38 (GND), A1.D2 (GND), BZ1.2 (-), C10.1, C11.2, D16.2 (A), NT1.1, SW1.1, SW2.1; also elsewhere on the board
GNDA: A1.33 (AGND), NT1.2; also elsewhere on the board
GPIO0: A1.1 (GPIO0); also elsewhere on the board
GPIO1: A1.2 (GPIO1); also elsewhere on the board
GPIO8: A1.11 (GPIO8); also elsewhere on the board
GPIO9: A1.12 (GPIO9); also elsewhere on the board
GPIO21: A1.27 (GPIO21); also elsewhere on the board
GPIO22: A1.29 (GPIO22); also elsewhere on the board
unnamed: A1.20 (GPIO15), R48.1
unnamed: A1.25 (GPIO19), R49.1
unnamed: BZ1.1 (+), R49.2
unnamed: D16.1 (K), R48.2
PIN_RUN: A1.30 (RUN), R15.2, SW1.2; also elsewhere on the board

Notes on the sheet:
RESET_BUTTON
BOOT_BOTTON

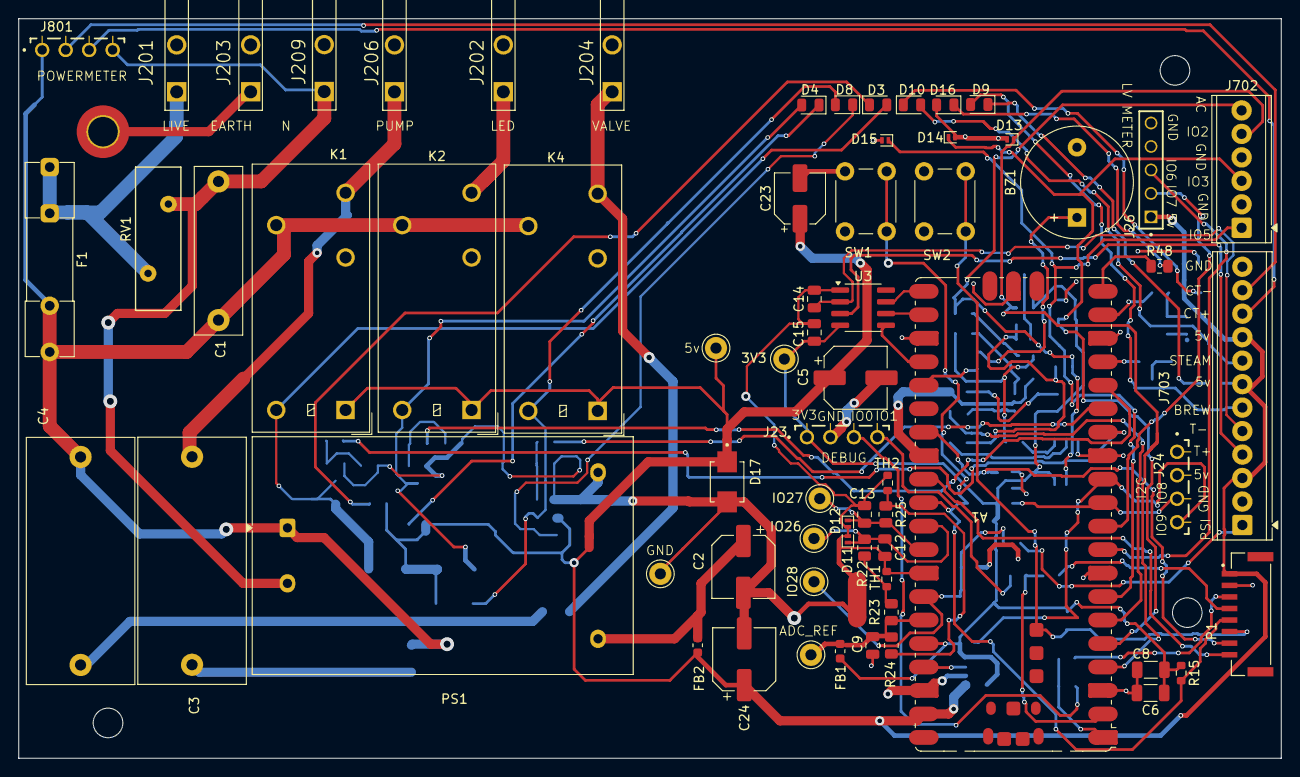
[picture p24: board ECM Synchronika Custom Control Board.kicad_pcb from above]

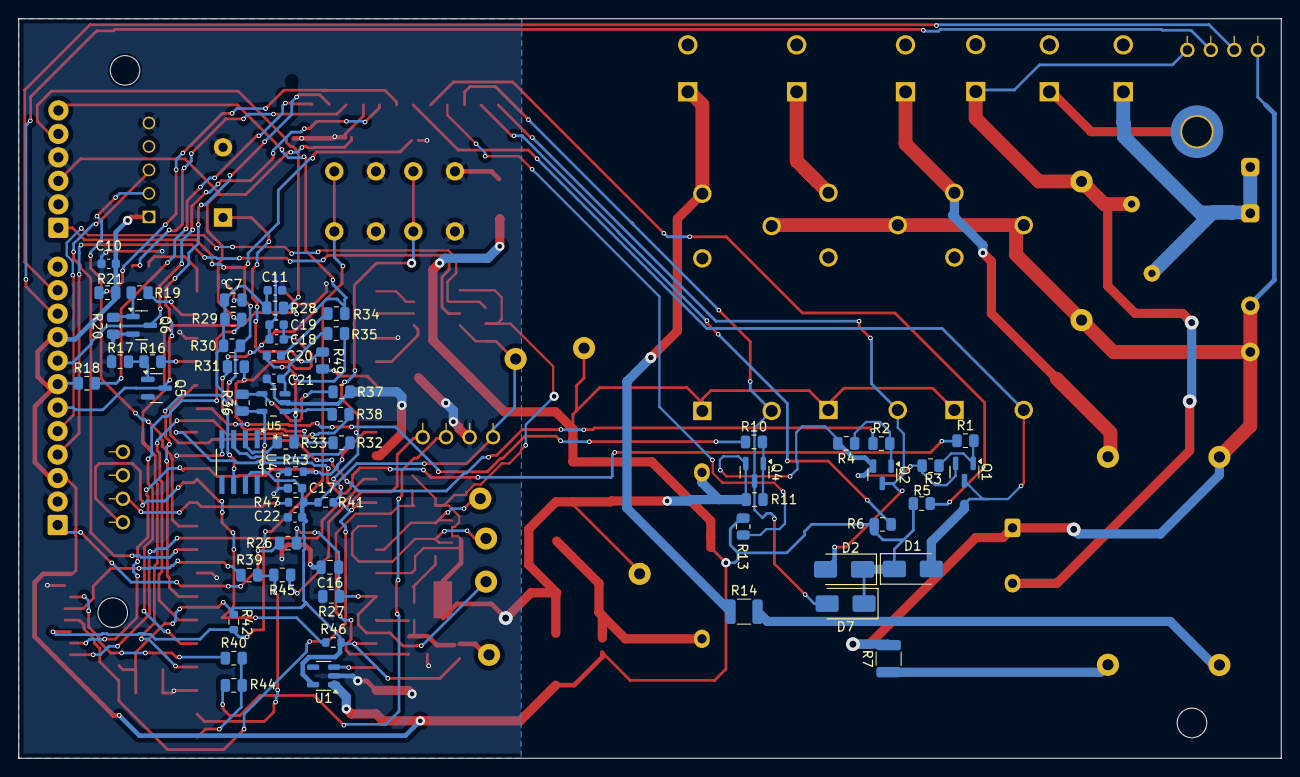
[picture p25: board ECM Synchronika Custom Control Board.kicad_pcb from below]

Board: 2 copper layers, 136.6 x 80.0 mm, 133 parts (61 on the bottom side), 80 nets.
