oyeniyihakeem08-blip/ECM-Synchronika-Custom-Control-Board/(commit log)

2025-11-29 init project
    [5V_ TO_3V3.kicad_sch, ECM Synchronika Custom Control Board.kicad_pcb, ECM Synchronika Custom Control Board.kicad_sch, HLK-5M05.step, HV_INPUT .kicad_sch, K2+RC SNUBBER.kicad_sch, MCU.kicad_sch, PICO SC0915.step]
2025-11-29 SCHEMATIC CONTINUATION
    [5V_ TO_3V3.kicad_sch, ECM Synchronika Custom Control Board.kicad_sch, HV_INPUT .kicad_sch, MCU.kicad_sch, Relays+RC SNUBBER.kicad_sch, SENSOR INPUT.kicad_sch, SSR.kicad_sch]
2025-11-29 Update KiCad project files
    [ECM Synchronika Custom Control Board.kicad_sch]
2025-12-03 Deleted Spare relays
    [SENSOR INPUT.kicad_sch]
2025-12-05 Updated PCB files
    [ECM Synchronika Custom Control Board.kicad_pcb, ECM Synchronika Custom Control Board.kicad_sch, HV_INPUT .kicad_sch, MCU.kicad_sch, PORTS.kicad_sch, Relays+RC SNUBBER.kicad_sch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]
