oyeniyihakeem08-blip/ECM-Synchronika-Custom-Control-Board/(notices)

Notices in the files:
3D MODELS/5 PIN HEADER HORIZONTAL MTSW-105-24-G-S-155-RA.stp:
author */ ('License CC BY-ND 4.0'),
